sinara-hw/Thermostat_EEM/README.md

# Thermostat_EEM
Thermostat with 4 TEC and 8 sensor channels in EEM form factor

## Design Files

Design files (schematics, PCB layouts, BOMs) can be found at [Thermostat_EEM/Releases](https://github.com/sinara-hw/Thermostat_EEM/releases).

## Wiki

More information can be found on the [wiki](https://github.com/sinara-hw/Thermostat_EEM/wiki).
