sinara-hw/Thermostat_EEM/(threads)

Thread 1 (2020-10-12):

module specification

gkasprow, 2020-10-12:
@jordens
- Do we need PoE?
- I assume that we can connect all AFEs to the same SPI interface, 4 chips per SPI
- DACs will share same SPI interfaces - two chips per SPI
- do we need individual PWMs for each TEC channel?
- I assume we want a downstream/upsteream EEM channel like in the Stabilizer. Was it tested already?
- what connectors? We can use ribbons with DSUB placed on separate panels as in the original Thermostat. But this takes a lot of space. We can also use HD DSUB and have 2 TECs and 4 sensors in each HDSUB15. In this way, noone will mix them with Thermostat or RS232 :) These days nobody is using VGA.

jordens, 2020-10-12:
> * Do we need PoE?

Not strictly need it if causes problems. But it fits the power envelope and would play nicely with the rest of the hardware.

> * I assume that we can connect all AFEs to the same SPI interface, 4 chips per SPI

Yes.

> * DACs will share same SPI interfaces - two chips per SPI

Yes.

> * do we need individual PWMs for each TEC channel?

You mean one MAX1968 per TEC? Yes.
Or do you mean the I/V limit PWMs? Those can be banked, let's say two TECs per set of voltages. But let's try to keep them as separate as possible.
But I might be misunderstanding you.

> * I assume we want a downstream/upsteream EEM channel like in the Stabilizer. Was it tested already?

With Stabilizer not that I know of. With Humpback and Urukul yes.
If there are space/pin problems, I'd rather drop the EEM connector but keep PoE.

> * what connectors? We can use ribbons with DSUB placed on separate panels as in the original Thermostat. But this takes a lot of space. We can also use HD DSUB and have 2 TECs and 4 sensors in each HDSUB15. In this way, noone will mix them with Thermostat or RS232 :) These days nobody is using VGA.

I'm only waiting for someone to connect a monitor to a Booster main board ;)

Do you mean [DE-15](https://en.wikipedia.org/wiki/D-subminiature)? Fine with me.
@j-hirsch and FBH should weigh in.

gkasprow, 2020-10-13:
The pinout could be as follows
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

gkasprow, 2020-10-21:
It looks like we will have individual PWM channels for all TEC driver settings.

gkasprow, 2020-10-28:
Initial placement
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

jordens, 2020-10-28:
When running one big tec from two channels in parallel, would we connect them on the header board?

gkasprow, 2020-10-28:
I'm not 100% sure if you can easily run two channels in parallel. These are synchronous converters - even a small differences in duty cycle will result in high cross-current flowing within the pair of shorted outputs. The header board is for debugging purposes.

jordens, 2020-10-29:
Aren't the drivers effectively current sources which should work in parallel? FBH indicated that they need one case with two in parallel. Best to disuss with @j-hirsch @schiemangk.

jordens, 2020-10-29:
Alternatively it might be easy to just use two electrically separate half-size TECs to get the same result.

hartytp, 2020-10-29:
looks nice! Any further thoughts about power management here? Can you get enough juice out of a single EEM for that many TEC drivers?

jordens, 2020-10-29:
It'll need active power management and load sharing anyway. EEM is probably not going to be the use case for us but the connector/cable is probably not going to be the limitation. It's just there because we can.

Closed 2020-11-03.

Thread 3 (2020-10-28):

CPU signal assignment

gkasprow, 2020-10-28:
@jordens Please have a look at the CPU signal assignments.
It should be coherent with the STM32MX project
[Thermostat_8CH.zip](https://github.com/sinara-hw/Thermostat_EEM/files/5454705/Thermostat_8CH.zip)

jordens, 2020-10-29:
Looks good!

* What do you think about PWM for the fan?
* Can we add some minimal mounting studs or other arrangement for the fan?
* (Note to self: use AIN[0-3] vs AIN4 for NTC symmetry measurement, leakage/bad connection, thermocouple voltage check.)
* Is there something useful we can do with the ADC GPIO? Maybe enable/disable Vref+ (at R36, which I'd really like if possible)? Or at least a SMT LED?
* Agree to go for the 2 channel ADCs for compat and higher sample rate (I think).
* You are not worried that P3V3DVDD might make P3V3AVDD dirty. You change the power supply topology there I think.
* Can we use the remaining two pins on J2 for I2C? Preferrably a separate bus but if that doesn't work with BSS138 isolation.
* One EEPROM with EUI-48 is enough. IC12 can (DNP) go onto the header board (behind the J2 I2C: I2C2).
* What's the bit-bang SPI note for?

I'll go through the CPU assignments later.

jordens, 2020-10-29:
@gkasprow Could you elaborate a bit on the ideal diode design? All I know is [this](https://www.microfarad.de/blog/the-ideal-diode/). Doesn't the body diode always power downstream EEMs and also lead to POE_PWR_SRC being at best one body diode drop below 12V?

jordens, 2020-10-29:
Could we also add support for the unipolar MAX1969? Would only be a beefy jumper from LX2 to LX1 I think (and DNP L4, short C66 C67).

gkasprow, 2020-10-29:
the MOSFET is off by default. When forward currents starts passing via FET diode, the  from EEM to 12V rail, the T10A gets disable and MOSFET is on. Even cunducting FET has enough voltage drop to keep the T10 in off state.

jordens, 2020-10-29:
Ah. I just didn't look close enough. The body diode is reverse biased in the situation I was thinking of.

jordens, 2020-10-29:
@gkasprow I added a couple items to my list above. Really good.

jordens, 2020-10-29:
And finally one idea: can we add headers to support bridge/kelvin measurements on the ADC channels? Just a 16 way DNP IDC header (4 pins per channel with vexc+, sense+, sense-, vexc-) and two 0R jumpers added between vexc+ vsense+ and vexc-/vsense-.

jordens, 2020-10-29:
@gkasprow I added and clarified a couple of the points above.

gkasprow, 2020-10-31:
Let's add 8pin IDC connectors, it's easier to fanout them to DSUB using IDC connectors

gkasprow, 2020-10-31:
I moved the PWM_maxINeg1 to PB5 to free the PC7 which is now TIM8_OC2 and steers the fan PWM

gkasprow, 2020-10-31:
I don't want to make the excitation switchable using MOS switches. What I can accept is a miniature relay. Shall I go for it or 0R resistors are fine? You can always place jumpers on neighboring pins of the IDC8 connectors to enable 2-wire mode without a need for soldering 0R resistors.

gkasprow, 2020-10-31:
I rearranged the placement:
- the PoE module is oriented vertically to make conduction cooling easier. It does not obstruct the air flow,
- all drivers and inductors are arranged vertically so a single heatsink will be able to cover them
- DC/DC is assembled in-line with drivers so can be cooled with a single heatsink/fan
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

gkasprow, 2020-10-31:
@jordens do you want to run all channels with full power? 30W PoE would not be sufficient. We would also need a stronger DC/DC converter.

jordens, 2020-11-01:
ACK the timer move, the IDC connectors, and the arrangements

We'll do active power limiting for both temperature and total supply load. It would be nice to get a current shunt and CPU ADC channel on the 5V or 12V rail in addition to the per-channel power measurements that we already have.
If you already have nice 5V DC-DC blocks that can do a bit more current in mind, that would be interesting when using the Molex/barrel. But more PoE power is a bit awkward infrastructure-wise.

If you don't like to support alternating excitation with switches then let's leave it. Testpoints for GPIO01 instead please.

For the measurement configurations I'd like to ensure the following (I hope the notation is ok):

* Topology on the board should be: Vexc+ Re Vref+ Rr+ Vsense+, and then Vref+ Rs Vsense- Rr- Vref- Re Vexc-
* Rr+-, Rs are same size SMT reference resistors (like the current 5k). Re can be regular size (but having the same size as the 5k ref would be nice) and there only needs to be one set per ADC.
* Vexc+, Vref+, Vsense0+, Vsense0-, Vsense1+, Vsense1-, Vref-, Vexc- are on the IDC connectors.
* Vsense+, Vsense-, and the four Vref- (instead of the GND) are on the D-44 connector.
* For NTC/ratiometric (default): Re = 0, Rr+- = 5k, Rs = DNP, NTC between Vsense+-
* For 4/6 wire/kelvin/bridge: Re = custom/DNP, Rr+- = Rs = DNP, bridge betweeen Vref+- and Vsense+-
* For single-ended measurements with 4 NTCs per ADC (still fully ratiometric), Re = 0, Rr- = DNP, Rs = Rr+ = 11k, NTC_A between Vref- and Vsense+, NTC_B between Vref- and Vsense-.
* Make sure Vref+/- and ADC REF+/- are tied together well, and then tied to the low-passed AVDD/AVSS.
* Make sure AIN4 is tied to Vref-.

Forget about the I2C on the D-44 connector. I don't think that's worth it. Let's do identification and management on the current controler.

gkasprow, 2020-11-01:
@jordens The scenario could be simplified using one DPDT relay. Reed relays are recommended because they don't require minimum operating current as regular relays do. Can you make a paper drawing of the idea? I got lost with these Rr+-
What do you mean by the topology on the board? PLacement of test points?
We don't have any free CPU pins, but I can add I2C current shunt.
stronger DC/DC is not a problem, I can also use two existing ones in parallel.

jordens, 2020-11-01:
Alternatively if you think it may be a good idea to I2C on the header board, then we could reduce the number of wires per TEC to 2. People seem to be talking about 5 A per contact and some 20 mOhm or thereabouts.

gkasprow, 2020-11-01:
What we can do is to reduce the number of TEC wires to two. We will spare 8 pins. Maybe, with SPDT relays we could scrap the internal IDC connectors ?

jordens, 2020-11-01:
Poor man's sketch of the four different use cases I have in mind and the IDC/D-44 and ADC connectivity.

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

Hope that's clearer.

I'd prefer to have at least the four Vref- on the D-44 connector. That would support 16 NTCs with still really good measurement quality.

jordens, 2020-11-01:
To support that kind of chopper mode, we'd need a DPDT relay per ADC to commutate Vexc+- between Vss/Vdd. The relay would be driven from GPIO0 by the ADC sequencer automatically (MUX_IO). It would work with all four use cases. The configurable ADC delay for that looks perfect.

jordens, 2020-11-01:
If we can put all four Vref+ and the four Vref- onto the D-44 connector (by scrapping the third TEC wire) then we can scrap the IDC connectors. Vexc+- and 6 wire mode isn't that interesting to me.
On the D-44 we'd have then 4*2 TEC+, 4*2 TEC-, 8 Vsense+, 8 Vsense-, 4 Vref+, 4 Vref-, SCL, SDA, 3V3_MP, GND. Exactly 44 contacts.

jordens, 2020-11-01:
A 3 m 22 AWG wire has 150 mOhm resistance. That with forward and return and two contacts, that drops 0.45 V at 3 A. Which is a bit annoying. 3 contacts would drop 0.3 V.
Then again, if drop becomes critical, we can just pigtail fatter cables from the D-44. The D-44 still looks like the best connector for the panel. The rest is a question of cabline.

gkasprow, 2020-11-01:
One can also use P3V3 and GND as vexc+-, probably using 3V LDO.

gkasprow, 2020-11-01:
I will use MIC45212 which can give off 14A of current.

gkasprow, 2020-11-01:
@jordens If we route also the GND and VDD, which is the case with I2C, then all possible variants could be possible.
Since we don't need live reconfiguration, I would simply add DIP switches that configure the resistor network. 6 position DIP switch would do the job. Alternate actuation is also ok, we need only DPDT reed relay (20$). Reed relays also introduce very low thermoelectric potential.

gkasprow, 2020-11-01:
Such schematic should do the job.
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

gkasprow, 2020-11-01:
I'm not sure if we can use alternate excitation due to limitation of REF inputs
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
REF inputs can be buffered so we can use identical protection/filtering as in the case of analog inputs.

gkasprow, 2020-11-01:
This is the proposed protection of VREF inputs
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

jordens, 2020-11-02:
The REF+- wiring, MIC45212 look good.
I don't like the DIP switches for the resistor network configurations. I'd rather just have this done in rework.
With the Vexc commutation voltage offsets (due to thermoelectrics or MOSFET resistances) would not be a problem. They are cancelled by the measurement methods. But if -- as you say -- `REF+ >= 1 V + REF-` (I'm somewhat unsure whether this is required) then we can't do it this way. Let's leave it without Vexc commutation and just put test points onto GPIO0/1. I don't like the idea of placing the commutation between Vref and Vsense instead.
Also what's the lifetime cycles of those reed relays? We'd be switching them at 20-50 Hz. That's 1e6/day.

gkasprow, 2020-11-02:
1e6 is too much. They have 1e7..1e8 without load
Do you afraid of the DIP switch's performance? They are not hermetic and after some time the contacts will degrade. We can of course substitute them with reed relays but that would be costly. Another option is [OPTO-MOS](https://datasheet.octopart.com/AQY212EHAX-Panasonic-EW-datasheet-13536469.pdf) relays that have a few tens of Ohm ON resistance, 1e-12 off current, and no leakage to GND at all.

jordens, 2020-11-02:
My thought was to commutate Vexc between successive samples to zero out thermoelectric voltages etc. That can be implemented with the ADC sequencer at maybe 25 Hz. Vexc+ does not need to be very stable, not even between the two polarities, it already has 66 Ohm impedance in Thermostat-v2.0. Only REF+- need to track Vref+- accurately. But if we believe that REF+ > REF- then we can forget about it. Note that the manual also says "The device functions with a reference magnitude from 1 V to AVDD1" suggestiing that the magnitude of the differential counts. But then it says "REF− can span from AVSS to AVDD1 − 1 V" and "REF+ can span from AVSS + 1 V to AVDD1" which mostly exclude it. Let's consider actively commuting Vexc dead.
I don't like the DIP switches to implement the different resistor options in the signal path (or for commutating) because they are physically large, thus take up space and can have significant temperature gradients with thermoelectric potentials. And most importantly I'd expect that  they won't remove the need to change resistors for some applications and the sensor end of the cable will need reconfiguration and soldering anyway. If the single-ended ratiometric option and the bridge measurements prove useful and work well, then I'd be happy to reconsider the DIP switches. What do you think?

Also, if you go for a separate LDO for Vexc+, can we up the voltage (AVDD1 = Vexc+, and maybe also AVDD2) a bit towards the 5 V the ADC can handle? I'd expect dynamic range to increase a bit. I think we can share one LDO among all ADCs.

gkasprow, 2020-11-02:
that's not that bad with DIP switches area.
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
The idea was to just label them 1,2,3,4 where every number means one of the sensor scenarios. So the user simply toggles certain combinations of switches and gets desired input configuration.
I already implemented dedicated LDOs for analog and digital ADC rails.
5V AVDD is OK, the same for Vexc. The ADC can work with neraly any combination of IOVDD and AVDD
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
What if we toggle excitation of the input signals instead of REF?

jordens, 2020-11-02:
I still don't see us making much use of the DIP switches. If I needed DIP-switchable configurations and could live with them in the signal paths, I'd put them on the header board on other side of the cable.

Commutating Vsense+- doesn't help with thermoelectric voltages (you need to commutate the drive as well) and the ADC can already mux the inputs in any configuration. We'd need to commutate Vref+- while leaving the REF+- polarity fixed. That's tricky since that commutation would sit in the signal path where it easily introduces non-symmetric offsets.

jordens, 2020-11-02:
Do you think it makes sense to use two AD7172-4 instead of four AD7172-2? Price per chip is the same, programming and software is compatible. The only downside I see is the lack of the temperature sensor and internal reference (which we don't use).

jordens, 2020-11-02:
Could you explain the reset circuit with the diode between the SWD/JTAG NRST and the CPUT NRST/IC13 reset generator? The reset generator is push-pull but this way the JTAG/SWD can't reset the CPU (only monitor the reset?) and the connection seems useless then.

gkasprow, 2020-11-02:
True, I was already writing that since we have 3V3 and GND, we can realize all scenarios on the header board. So no resistors are needed. I would simply put only default configuration, rest of them can be build using dedicated header boards.
In case of ADC the price is not a big contribution, it's better to use components already used in other designs.

gkasprow, 2020-11-02:
the reset chip is push-pull, it keeps the RSTn pin low for a certain time after power on. Then its output is high and the debugger can pull RST low. The net name should be called RSTn, not RST
The JTAG JRST is not connected now.

jordens, 2020-11-02:
Ah. I mixed up where µC NRST is connected (RST and not CPU_RESETn).

You are right about the resistors not being needed at all here. They could and maybe should all be on the header board! But then we definitely need Vexc- (i.e. GND) and Vexc+ (P5V0A from the LDO, not 3V3) on the D44 connector.

* 4x2 TEC+, 4x2 TEC-
* 8 Vsense+, 8 Vsense-, very high impedance
* 1 Vref+, 1 Vref-, shared among the 4 ADCs, very high impedance
* 1 Vexc+ = 5V0A, 1 Vexc- (GND), low impedance
* SDA/SCL/GND/3V3_MP
* Use the remaining 4 contacts to beef up two TEC drives.

I'm still unsure whether it's better to have I2C on the header board or instead use those four contacts to beef up all TEC connections to three contacts.

jordens, 2020-11-02:
And it's not the best idea to connect AIN4 to REF- since REF- is available as a dedicated mux input already. If you don't have another idea, I think it's best to connect AIN4 to REFOUT (2.5 V reference that we don't use, which is not available as a mux input which gives us a nice (indirect) handle on measuring all relevant frontend voltages single-ended and absolute (measure REFOUT/REF- against REF+/REF-, then measure AIN0-3/REF- against REF+/REF-.

gkasprow, 2020-11-02:
why not use 3V3 LDO on the header board and supply I2C from Vexc+? I2C won't be used often. In this way we would keep all 4 vref pairs

jordens, 2020-11-02:
Yes. Sounds good.

gkasprow, 2020-11-02:
So, to conclude, I will keep only the default symmetrical ratiometric connection.
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

jordens, 2020-11-02:
Yes. Exactly like that. Connect Vref- to REF- and Vref+ to REF+. Bring VREF_5V0 and GND to the connector. No need for the net-ties NT6 and NT2 anymore.

gkasprow, 2020-11-02:
Right, the net ties were needed to avoid the wrong GND routing

jordens, 2020-11-02:
I'd like to change the TEC_U_Meas circuit to be referenced to the MAX Vref 1.5V (not (CPU ADC_REF + REF_GND)/2). That makes these MAX voltages all consistently referenced.
Could you also remove the DAC_FB circuitry? I don't want to use it and instead find the overall offset with ITEC or TEC_U_Meas vs the MAX Vref 1.5V. At least DNP R69 by default and feel free to use those CPU ADC inputs for something else (sensing the 12V current shunt for example).

jordens, 2020-11-02:
I'd also like to be able to measure the P3V3 voltage because the PWMs are proportional to it. The best way I see is to connect VBAT to a scaled P3V3 and then measure VBAT relative to VREFINT (~1.2V) or P5V0A/CPU_ADC_REF.

gkasprow, 2020-11-02:
Right, we have ITEC and TEC_U so these are suffienct means to verify that DAC works. We have free ADC inputs, so we can measure 3V3 directly.

gkasprow, 2020-11-02:
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

gkasprow, 2020-11-02:
the 3V CPU reference generation uses 1% resistors and opamp buffer with offset of 7mV max . Do we need better precision?

gkasprow, 2020-11-02:
I mean this circuit
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

jordens, 2020-11-02:
No. 1% is fine. for me.

gkasprow, 2020-11-02:
I added a new schematic release. Please check it.

jordens, 2020-11-03:
Thanks. I filed individual issues and I think we can close this one.

Closed 2020-11-03.

Thread 11 (2020-11-03):

MAX1969 option

jordens, 2020-11-03:
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

We should move the jumper behind the inductors L2 and L4 to utilize them in parallel and C67/C66 as well.

This should be:

* a jumper between the right sides of L4 and L2 (DNP for bipolar)
* a jumper between the right side of L4 and OS2 (DNP for unipolar)
* (done) a jumper from OS2 to GND (DNP for bipolar).

Can we easily make all three jumpers and the CMC capable of 6 A? If not, 5A is also fine.

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

gkasprow, 2020-11-04:
I replaced the CMC with a[ 1.8uH 9A](https://pl.mouser.com/datasheet/2/336/P850-1527002.pdf) one. Slightly bigger but fits nicely.

gkasprow, 2020-11-04:
I used dedicated 1206 0.5mR jumpers. Standard 0R 1206 resistors are roughly 50mOhm

gkasprow, 2020-11-04:
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

Closed 2020-11-04.

Thread 13 (2020-11-03):

D-44 pinout

jordens, 2020-11-03:
Feel free to shuffle this for most convenient routing on Thermostat and on the header board. I don't care about the pin ordering.

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

gkasprow, 2020-11-03:
I already changed the layout twice to make routing of high current lines easier I will Y-mirror it.

Closed 2020-11-03.

Thread 14 (2020-11-03):

testpoints for MaxCurrentNet/Pos/Voltage

jordens, 2020-11-03:
Could you move those testpoints behind the reconstruction filter?

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

gkasprow, 2020-11-03:
Are U sure?
In the case of DMM, it does not matter, but currently, you can also observe the PWM pattern.

jordens, 2020-11-04:
Ack

Closed 2020-11-04.

Thread 15 (2020-11-03):

Power budget, various notes

jordens, 2020-11-03:
When done, update the power budget. Also remove that note from the top sheet (or from the TH8_Supply.schdoc). It's duplicate.

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

Add a Testpoint and a note to ADC_CLKIO saying: "2 MHz"

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

Closed 2020-11-05.

Thread 16 (2020-11-03):

Supply connectors for sensors.

jordens, 2020-11-03:
If we supply the connectors for the TECs, we should also supply the ones for the sensors.

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

gkasprow, 2020-11-03:
thanks for reminding me. I planned to do so but I forgot :)

gkasprow, 2020-11-04:
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

Closed 2020-11-04.

Thread 17 (2020-11-03):

Fan CPU protection

jordens, 2020-11-03:
Can we increase R9? ~10 mA still sound like a lot going into the CPU pin. And the fan not working might be noticed pretty late.
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

gkasprow, 2020-11-03:
right. it's probably too low to cause latch-up, but for this frequency, 10k would work as well

Closed 2020-11-03.

Thread 18 (2020-11-03):

Allow EEM/Molex/Barrel 12V to be measured with the shunt

jordens, 2020-11-03:
These should drive P12V0_R

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

jordens, 2020-11-03:
And the EEM (by default) as well.

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

gkasprow, 2020-11-03:
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

The only issue is that the load connected to EEM is not measured.
What we can do is to add yet another FET that would redirect the current when powering downstream port
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

jordens, 2020-11-04:
I don't think that's necessary. But I'll leave it to you.

gkasprow, 2020-11-04:
let's keep it simple then.

Closed 2020-11-04.

Thread 19 (2020-11-03):

I2C isolation

jordens, 2020-11-03:
Let's use CPU_RESETn to drive those FETs. It's later than P5V0 and later than P3V3

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

jordens, 2020-11-03:
I'd also place the LM75 on the EEM side of the I2C bus (I2C_SDA/SCL instead of I2C4_SDA/SCL)

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

jordens, 2020-11-03:
And we need 10k pullups to P3V3_MP on the EEM side of the I2C bus (I2C_SDA/SCL).

gkasprow, 2020-11-03:
I'd use P5V0A which wakes up as the last one after P3V3. It will result with lower Rdson.

gkasprow, 2020-11-03:
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

Closed 2020-11-03.

Thread 21 (2020-11-03):

board guide keepout

jordens, 2020-11-03:
We should not put top layer traces into the board guide area. That'll work against metallic enclosure edges and wear of the solder mask. It's also no good for cPCIs IIRC.

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

gkasprow, 2020-11-03:
that's not top layer. The trace is on L2. It may look misleading due to prepreg transparency settings:)

jordens, 2020-11-03:
Ah. Ok then!

Closed 2020-11-03.

Thread 22 (2020-11-03):

PoE again

jordens, 2020-11-03:
A few thoughts:

Looking at the [SMSC app note on PoE](http://ww1.microchip.com/downloads/en/AppNotes/en562768.pdf), they recommend a different circuit for protection: back-to-back 3.3V TVS/Zeners accross RD and TD. Apparently lots of capacitance allowed here (50 pF differential).

Second, I'm a bit worried about the mismatch between the [ESD diode datasheet](https://www.onsemi.com/pub/Collateral/NUP4114-D.PDF) and the schematic symbol:

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

Unlike the symbol, in the datasheet there is no explicit protection of the data lines to AVDDT_PHY at all. It's only a Zener + forward diode to GND. And that Zener has 8.3 V clamping voltage (1 A) and 6.5 V breakdown (1 mA): higher than the abs max of the [PHY](http://ww1.microchip.com/downloads/en/DeviceDoc/8742a.pdf) (3.3 V + 2 V = 5.3 V), higher than expected from the schematic symbol if it was only a forward diode drop to 3.3V (AVDDT_PHY), and higher than the 3.5 V "punch-through" + forward diode drop or 4.5 V clamping (1A) plus forward diode of the [SMSC design](http://www.farnell.com/datasheets/1749617.pdf).

Third, I think in our design the AVDDT_PHY protection of 8.5 V is still a bit loose compared to the 3.6 V abs max of the PHY. Yes, there is plenty of capacitance to dampen the surge, but still. Needs to be compared to the ~20V*1µs transients that the SMSC App note shows.

TI [talks](https://www.ti.com/lit/ug/tidues1a/tidues1a.pdf) about [ESDS312](https://www.ti.com/lit/ds/symlink/esds314.pdf) and [LC0-3.3](https://www.littelfuse.com/~/media/electronics/datasheets/tvs_diode_arrays/littelfuse_tvs_diode_array_lc03_3_3_datasheet.pdf.pdf) 3.3V clamps/ESD/surge/lightning protection.

Also re https://github.com/sinara-hw/Thermostat/issues/83

This also applies to the other instances where we use that ESD diode pack (USB, 3x I2C, JTAG) and Stabilizer and Thermostat (non-EEM) as well.

gkasprow, 2020-11-03:
True, the symbol is wrong!
This could explain why PHY died.
Good catch!
We also need to replace it with the Stabilizer module.
Fortunately, I did not update all other designs with this part!
What we need is not necessarily Zener diode but fast protection diodes where excessive charge can be dumped to the supply rail. This would work
https://datasheet.octopart.com/PRTR5V0U4Y%2C125-Nexperia-datasheet-87582156.pdf

gkasprow, 2020-11-04:
I'm not sure if the cathodes can be connected to 3V3 rail. It will limit the max voltage produced by the PHY chip (there is a transformer with center tap). Maybe we should connect it to 5V rail instead...

gkasprow, 2020-11-04:
the maximum ratings say:
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

gkasprow, 2020-11-04:
on the other hand, the TX won't exceed 1V
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

gkasprow, 2020-11-04:
which means that we have AVDDPHY + 0.5V on one output and AVDDPHY -0.5V on complementary output. The TVS diodes should not clip such amplitude

jordens, 2020-11-04:
I always thought they were complementary and just switch between 0 and avddphy. I would not expect them to get above avddphy actively. There will always be one inactive half of the winding. Induced voltages in the inactive half should be clamped to avddphy+diode in the phy. No?

gkasprow, 2020-11-04:
These are analog signals. 3-state sequence. The transformer central tap is connected to 3V3, so when one output pulls low, the other gets the same value above the bias. The PHY does not have the clamping diode (it accepts up to 5.3V), it's like an open-drain circuit. That's why it can be vulnerable to damage.

jordens, 2021-05-04:
Note for the next time we revisit this: We could also try "more robust", "industrial" PHYs like the DP83822.

gkasprow, 2021-05-04:
Good ida. But I would do it in case we observe chip failures.

Closed 2020-11-04.

Thread 4 (2020-11-03):

P5V0A as Vexc on the header board

jordens, 2020-11-03:
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

Not P3V3_AFE.

Also maybe add (a ferrite bead and) 100 n decap to P5V0A on the header board.

jordens, 2020-11-03:
And I think we may want to add a polyfuse on Thermostat towards the D44 connector P5V0A.

gkasprow, 2020-11-03:
This comes from 300mA LDO. I'm not sure if it's worth adding PTC to BOM

jordens, 2020-11-03:
Right. I guess the LDO will just shut down.

gkasprow, 2020-11-03:
yes, it will get thermal shutdown.

gkasprow, 2020-11-03:
on the header board, we have 33Ohm series resistor already

jordens, 2020-11-04:
That's for the P3V3_AFE LDO, right? For the excitation voltage to the sensor connectors I'd like P5V0A with no large added resistance, just some filtering. (e.g. load cells are just a couple hundred Ohm only and like to pull > 10 mA at 5 V.)

Closed 2020-11-03.

Thread 7 (2020-11-03):

P5V0REF

jordens, 2020-11-03:
Do we need P5V0REF?

* The DACs don't need to be extremely accurate. They are in-loop and relative to the somewhat unstable MAX Vref.
* The CPU ADC reference is as inaccurate as the resistors/buffer.
* The P5V0A seems clean and has enough power

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

jordens, 2020-11-03:
Maybe it's much better to have a 3V reference for the DACs and the CPU ADC. Then there would be no need for the IC10 buffer, the R54/R70 divider and the R88/R87 divider. Drive IC5 VDD from P5V0A with a bit of resistance to isolate it.

gkasprow, 2020-11-04:
Good idea. I don't remember what was the rationale behind supplying the DAC REF from 5V. The DAC performance is not critical here.

Closed 2020-11-04.

Thread 8 (2020-11-03):

P3V3IO

jordens, 2020-11-03:
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

Can't find it being used anywhere.

jordens, 2020-11-03:
I see that you use it for the ADC IOVDD. My PDF viewer didn't find it in a search.

You know best whether having a separate supply is necessary there. Fine with me.

Closed 2020-11-03.

Thread 9 (2020-11-03):

Check fan PWM

jordens, 2020-11-03:
On Phaser I couldn't get the fan to turn off.

https://github.com/sinara-hw/Phaser/issues/107

jordens, 2020-11-03:
Looks like you used BSS138 with the higher Vth. So let's try it and maybe short C82 in later revisions if it doesn't work.

Closed 2020-11-03.

Thread 23 (2020-11-07):

D44 assembly

jordens, 2020-11-07:
With the connectors like this, the two boards have to be separated before soldering the D44 connectors. Breaking on the drill line after soldering probably won't work because you can't bend the connectors when connected. Is this the intention?

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

gkasprow, 2020-11-07:
breaking will be easy
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

The connectors will be mounted after all, but U are right, they can be also mounted automatically - we have such machine. I will separate them a bit.

jordens, 2020-11-07:
Yes. I have seen the break line. But that breaks by bending and you can't bend the connectors when mated. So you'd have to make sure that they are mounted after breaking. I don't know how the assembly works and how much is done manually, but it might be easier to allow the board to be broken off after all assembly. That would require separating the boards by more.

gkasprow, 2020-11-07:
Actually we have a special machine that separates the boards. We don't break them manually.
It's logistically easier to do after automatic soldering. Once you separate them, It's hard to grip it for automatic soldering...

jordens, 2020-11-07:
Right. As mentioned I thought that you solder before separating. Then I wonder how the machine separates without bending or shearing (which would both stress the mated connectors a lot) and also without direct access to both sides of the drill lines.

jordens, 2020-11-08:
I guess if it's a saw that does the separation, this is fine.

gkasprow, 2021-01-19:
I separated the two boards
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

Closed 2021-01-19.

Thread 24 (2020-11-07):

P5V0_AFE as Vexc on the header board

jordens, 2020-11-07:
Still #4.

* I'd like to have P5V0_AFE to serve as Vexc (pin 8) on the connectors J7,J8,J11,J13, not P3V0_AFE.
* That's why on the header board I'l like more filtering capacitance for P5V0_AFE.
* The P5V0A trace to the D44 connector on the main board should also become a bit thicker (8*10 mA) as should the trace on the header board.

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

gkasprow, 2020-11-07:
Right, 3V3 doesn't make much sense here

gkasprow, 2021-01-19:
I added FB + 100nF, also routed dedicated 20mils trace directly to the LDO

jordens, 2021-01-19:
LDO? That should be P5V0_AFE.
The LDO is only for the EEPROM, right?

gkasprow, 2021-01-19:
Yes, it is only for EEPROM.

Closed 2021-01-19.

Thread 25 (2020-11-07):

CurrentSet needs filtering

jordens, 2020-11-07:
I think there should be RC filtering on the DAC output since it uses 10 kHz PWM to get the two LSBs. Something like 1 kHz seems good.
We can also just use 16 bits and then there won't be PWM tones.

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

gkasprow, 2020-11-07:
OK, it was there originally, I forgot why :)

gkasprow, 2021-01-19:
done
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

Closed 2021-01-19.

Thread 27 (2020-11-07):

AIN4 to GND

jordens, 2020-11-07:
(Reverses https://github.com/sinara-hw/Thermostat_EEM/issues/3#issuecomment-720581202)

* AIN4 should be connected to GND to measure single ended voltages easily.

I misread the AD7172 datasheet and didn't see the option to use the internal reference independent of what's connected to REF+-. Sorry about the confusion.

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

gkasprow, 2021-01-19:
done
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

Closed 2021-01-19.

Thread 28 (2020-11-07):

P5V0A load

jordens, 2020-11-07:
I think the R at the P5V0A LDO input needs to go away. ADCs, DACs and the Vexc branches are about (3 + 1 + 20 mA) * 4 ~ 100 mA max. That would bee too much for that 1/16 W resistor.

* Maybe just R105 = 0R? The ADCs and DACs have their own RC filtering already.

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

gkasprow, 2021-01-19:
we already use 10R 0805 resistors so I will place two in series.

Closed 2021-01-19.

Thread 29 (2020-11-08):

polarity marker for jtag connector

jordens, 2020-11-08:
* Since it isn't keyed, it should at least get a pin-1 marker, https://github.com/sinara-hw/Thermostat/issues/76
* Also make sure that the connect fits, see https://github.com/sinara-hw/Thermostat/issues/75

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

gkasprow, 2020-11-08:
The PN used in the design is EOL.
What about using this one from Samtec, with the key?
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

jordens, 2020-11-09:
The non-keyed connectors would fit that one as well, right?
Then that's good. Still, please add a pin-1 marker if the footprint doesn't have one.

gkasprow, 2020-11-17:
Harwin M50-3600542R fits well existing footprint

gkasprow, 2020-11-17:
Connfly ZL322-2X5P works as well

gkasprow, 2021-01-19:
fiexd. I used  M50-3600542
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

Thread 30 (2020-11-09):

AD717[2567]

jordens, 2020-11-09:
Quick analysis of pin- and software-compatible alternative ADCs.

tl;dr: The AD7175 is an interesting option over the AD7172 for fast loops (faster than 50 Hz data rate).
Let's stick with the ad7172 for now.

* 2,5,6,7 are all pin-compatible and register compatible. This is stressend by the common ADI noOS driver.
* AD7175 is very similar to the 2, (almost) same base rms noise, but higher base sample rate (250 kS/s vs 31 kS/s, factor 8).
* AD7175 has 8 times higher clock/modulator frequency and about 8 times the current consumption.
* AD7176 is the AD7175 without buffers
* AD7177 has 32 bits but the same in-band noise as the AD7175. It's useful if the data rate is under 400 Hz compared to the 5.
* The 5's higher base sample rate (before the filters) at the same base quantization noise directly leads to less voltage noise (about sqrt(8)) at the same output sample rate.
* Once the filtered voltage noise drops below the filtered (24 bit) quantization, the later dominates. That's at 400 Hz and 60 Hz for the 5 and 2 respectively.
* Tempco is dominated by the 5ppm/K reference resistors. There are 2ppm/K resistors available from the same series. Going to <1 ppm/K reference resistors (through hole) and six wire measurement (remote excitation) or a <0.5 ppm/K current source and four wire measurement would start to make the ADC the dominant part. Both alternative setups are possible with the current design.
* The ADCs have 0.2 (AD7172) and 0.4 ppm/K (AD7175) typ. But looking at the actual distribution of those drifts they are indistinguishable to me. Unclear what the measurement accuracy is and the device drift might even be indistinguishable from zero.
* 10k||(5k+5k) Johnson noise in 500 Hz is 0.2 µV. 24 bit quantization is 0.17 µV rms. The two reference resistors additionally contribute 0.06 µV/V current noise (in one decade bandwidth, 1/f) each. We run them at 1.25 V.
* NTCs also have current noise. Maybe even 1 µV/V (20 µK/V) in 0.01-1 Hz depending on the design ([Ryger et al. Rev. Sci. Instrum. 88, 024707 (2017)](https://pdfs.semanticscholar.org/1198/54a2bf7d9f0db15f1273141bfb6e8449f83b.pdf). We run at 2.5 V.
* 50 Hz should be the sweet spot for the AD7172 (ENOB 24 bit and 50 Hz notch with minimal latency), 400 Hz for the AD7175
* The current design has a 160 Hz RC filter (200n, 10k||(5k+5k)) before the ADC limiting the bandwidth and latency
* Thermal gradients between effective temperature of interest and sensor are typically larger than 1 mK (50 µV, 1 µHz-0.1 Hz, after settling, with a decently designed multi-layer actively shielded commercial optical ULE cavity).
* For faster loops with closely coupled TECs, thermal mass, and sensors, or other types of sensors and measurements, the lower noise of the AD7175 is superior.

Current Thermostat noise is 0.5 µV [2.5 LSB](https://github.com/sinara-hw/Thermostat/issues/46) at 3.3 V ref and 27 S/s (0.45
 µV datasheet).

gkasprow, 2020-11-09:
For me is fine, it would be good to use it in both Thermostat designs.

jordens, 2020-11-09:
Agreed. These were just my notes what would need to be done to get to faster and even more accurate/stable/low-noise control loops.

Closed 2020-11-09.

Thread 31 (2020-11-09):

input filter capacitors

jordens, 2020-11-09:
Let's lower C105, C46, C110, C53, C120, C121 from 100 nF to 10 nF to get a 1kHz corner (10+(10||10) nF and 10||(5+5) k). This is still 120 dB at the first alias. Matches the 1 kHz corner filter after the DAC (https://github.com/sinara-hw/Thermostat_EEM/issues/25).

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

gkasprow, 2021-01-19:
Do the same in Thermostat as well?

gkasprow, 2021-01-19:
done

filipswit, 2021-11-22:
Modified:
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

Closed 2021-11-25.

Thread 34 (2020-11-10):

J7,8,11,13 Vrefbx- close to GND

jordens, 2020-11-10:
Please move Vrefbx- to pin2 close to the GND pin1 on J7/J8/J11/J13.

The pinout from pins 1-8 should be GND, Vrefbx-, SENSBx_2, SENSBx_1, SENSBx_2, SENSBx_1, Vrefbx+, P5V0_AFE.

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

gkasprow, 2021-01-19:
done
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

jordens, 2021-01-19:
Good idea! But then R129 and R130 should be treated the same. They should also move to the header board. and be placed accross pins 8-7 and 1-2 respectively.

And I'm not sure we need this section then anymore:
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

gkasprow, 2021-01-19:
right!

gkasprow, 2021-01-19:
done
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

Closed 2021-01-19.

Thread 35 (2020-11-10):

0805 footprints for reference resistors and wider sense traces

jordens, 2020-11-10:
Currently the reference resistors dominate the temperature coefficient (an order of magnitude more than ADC gain tempco, lead resistance tempco, lead thermoelectric emf, ADC offset tempco, resistor voltage coefficients).
A fix would be to get better resistors.

Those could in principle be on the (actual) header board. That would also cancel lead resistance tempco and lead resistance offsets/instabilities. Alternatively we could go to 0.2 ppm/C resistors. 5k is available in 0603 (Y16365K00000F0W). But many more resistors are available in 0805 size from 0.2 ppm/C (Y16295K00000T9R) to the existing 5 ppm/C.

* Could we go for 0805 size reference resistors (e.g. TNPU08054K99BZEN00 or better Y16295K00000T9R for R91 R44 R132 R50)? Resistance can be anywhere from 4.7-5.2k.

To stay below the effect of the reference resistor tempco (in the default 2 wire measurement configuration), the traces between the reference resistors and the NTC need to stay below 0.3 Ohm. That's 10 cm of 6x1.38 mil trace max (round trip).

* Could we widen the sense traces (SENS[01]_[PN] net from the reference resistors R91 R44 R132 R50 to the D44 connector and on the breakout board) to 10 mil?

gkasprow, 2020-11-10:
Sure, let's go.
The most precise ones are in the miniMELF package (1206). We have a lot of space.

jordens, 2020-11-11:
Are you sure? On digikey, the common SMT resistors around ~5k and 0.2 ppm/K are 0805, some 1206, no miniMELF.

gkasprow, 2020-11-11:
It used to be the case 15 years ago. It was easier to seal miniMELF. Bit it seems the situation changed recently :)

gkasprow, 2021-01-19:
Let's go for Y16245K00000T9R. I have them already in my libs.

jordens, 2021-01-19:
Agreed

gkasprow, 2021-01-19:
I added them on the header board, the ones close to DACs will be DNP
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

Closed 2021-01-19.

Thread 36 (2021-01-19):

cooling

gkasprow, 2021-01-19:
I added optional cooling - it consists of the fan (same model as used in Thermostat) and a piece of PCB or metal plate.
The mounting plate distributes the airflow between the channels. The inductors form the air duct so that should work.
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

gkasprow, 2021-01-19:
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

jordens, 2021-01-19:
Maybe that's also a useful approach for (https://github.com/sinara-hw/Phaser/issues/101#issuecomment-682044877)

gkasprow, 2021-01-19:
The mounting holes will fit.

Closed 2021-01-19.

Thread 38 (2021-01-19):

Move R129 and R130 to the header board.

jordens, 2021-01-19:
Good idea in #34! But then R129 and R130 should be treated the same.

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

They should also move to the header board. and be placed accross pins 8-7 and 1-2 respectively.

And I'm not sure we need this section then anymore:
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

_Originally posted by @jordens in https://github.com/sinara-hw/Thermostat_EEM/issues/34#issuecomment-763129398_

gkasprow, 2021-01-19:
I moved them and made that section DNP

jordens, 2021-01-19:
Perfect

Closed 2021-01-19.

Thread 39 (2021-01-20):

support for cryogenic temperature sensors

gkasprow, 2021-01-20:
I want to use Thermostat to sense 4K enviorenment using silicon sensors, for example one of [these](https://www.lakeshore.com/products/categories/overview/temperature-products/cryogenic-temperature-sensors/dt-670-silicon-diodes)
The diode characteristics is below
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
it should be easy - connect the ADC references to external reference voltage, for example 3ppm LM4140 which gives 2.048V
and then use current source based on opamp + LM4140 (1.024V) to generate 10uA current.
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

 Then use 4 wires to connect the sensor.
@jordens do you think that makes sense?

gkasprow, 2021-01-20:
Another option is to use a current sink that would use a common reference source for all channels, then eight opamps + 8 low leakage current JFETs

jordens, 2021-01-20:
The ADC has an internal 2.5 V 2ppm/K reference already. That's usually enough. I'd build a current source on the header board and implement Kelvin sensing.

Beyond that:
If you can make a good star-ground near the diodes and sense that with one of the input channels you'd get more diodes per ADC. You can also put several diodes in series of a CC source.
Maybe you could even use the REF+, REF- terminals as two additional independent inputs if you use the internal reference. The datasheet seems to indicate that they can be used as such. With a good star ground and REF- connected sensing, you could measure four diodes (AIN[0:3] against REF-).
Calibration, uncompensated Thermocouple voltages and lead resistance for non-Kelvin are probably the biggest problems.

gkasprow, 2021-01-20:
Sure, by writing "Then use 4 wires to connect the sensor." I meant Kelvin connection. I was thinking about using two similar references or even one with the hope that their tempco will compensate to some extent :)
2.048V reference will let me use more ADC range but the ADC one has a lower tempco.
I ordered calibrated thermometer so can use it as a reference. I want to implement some interpolation in the Thermostat firmware, connect 8 sensors attached to the same cold head as reference sensors and do the calibration automatically. It won't be that simple at 4K due to several possible issues, but I won't know until I try.

gkasprow, 2021-01-20:
Here is the proposed AFE for cryo sensors. The sensor wires are long, I want true differential inputs. 8 channels are fine.
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

gkasprow, 2021-01-20:
I'm not sure if the ADC will handle 5V common-mode signal..

gkasprow, 2021-01-20:
I can always add 120k resistor in series with P5V0_AFE...

jordens, 2021-01-21:
* With Kelvin I only wanted to say that I think your approach of 4-wire is exactly right.
* Why do you need the JFET and low-side drive of the diode? Can't the opamp drive high side excitation of the diode (if you want, through a resistor to protect the diode a bit)? (8: opamp out through 120k protection, 7+6: sense, 5: 120k burden/shunt to GND). That would also get the sense signals common mode away from the rails.
* I don't think a second reference for the ADC will help.

gkasprow, 2021-05-21:
right! we can scrap the MOSFET this way

Closed 2021-05-21.

Thread 40 (2021-02-03):

P5V0A protection zener

jordens, 2021-02-03:
Let's go for the slightly higher zener protection diode here. 1SMA5920BT3G, 6.2 V instead of 5.6 V.
The ADC has 6.5 V abs max and the CPU side is powered by an independent 3V3 supply.

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

In light of previous experience.

gkasprow, 2021-05-21:
done

Closed 2021-05-21.

Thread 42 (2021-02-15):

High power PoE

gkasprow, 2021-02-15:
There are 60 and 85W PoE [modules](https://silvertel.com/ag5800/) avaialble from Silvertel.
They need an 802.3bt class switch but are backward compatible with AT sources

jordens, 2021-02-15:
Nice. To me AT compatibility is crucial, I don't see BT switches very often.
I'm really looking forward to active temperature, total power management, sharing, and dynamic limiting on Thermostat and especially Thermostat_EEM.

gkasprow, 2021-03-01:
the  802.3bt  module has 17mm, it's too high for 4HP EEM

gkasprow, 2021-03-01:
But, [AG5810](https://silvertel.com/ag5810/) would fit. But would require significant board re-design

jordens, 2021-05-04:
Isn't the fan mezzanine (incl screw heads etc) too high for 4 HP anyway? Even if it just fits, wouldn't the fan choke on the proximity to the adjacent board?

gkasprow, 2021-05-04:
The idea is to use it when a convection cooling or fan tray is not used. In such cases, we could either install a 2HP filler or go for an 8HP panel.

Thread 43 (2021-02-17):

Stm32h7

jordens, 2021-02-17:
Let's consider moving to the stm32h7 right away. Price is almost the same, more power, newer architecture, lots of experience with it on stabilizer now.
I think there is a pin compatible stm32h743 to the f4 that we are using. It might just be a bom.change.

@gkasprow what do you think?

gkasprow, 2021-02-17:
Let's do whatever is easier from SW's point of view.

jordens, 2021-02-18:
Ok. Let's do stm32h743zit6 as on Stabilizer then. The H7 teething problems appear to be over and I can see the need for some additional computation power here.
I think this is a drop-in replacement but it's probably worth verifying the complete pin config.

c.f. old discussion at https://github.com/sinara-hw/Thermostat/issues/12

gkasprow, 2021-03-14:
done, please check the CubeMX project
[Thermostat__EEM_8CH.zip](https://github.com/sinara-hw/Thermostat_EEM/files/6137141/Thermostat__EEM_8CH.zip)

SingularitySurfer, 2021-03-17:
Hi, I looked at the schematic and I couldn't find anything wrong with the pinout. But I also don't know the exact timer/ADC configuration etc. and generally this is the first time I properly looked at Thermostat in depth. So maybe someone else should check as well.

jordens, 2021-03-18:
@gkasprow Is there a chance to group the timer channels a bit clearer? Specifically:

* Can we put PWM_maxINeg1 onto the same timer (TIM8) as the three other? I.e. swap FAN_PWM and PWM_maxINeg1.

gkasprow, 2021-05-21:
they are not mounted by default
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

Closed 2021-05-21.

Thread 45 (2021-10-20):

ADC_DOUT/RDY to SPI_MISO and EXTI

jordens, 2021-10-20:
It's useful to interrupt when the ADC is ready instead of polling. For that it's nice if we can use an EXTI interrupt from a GPIO input pin concurrently with SPI. Then we don't have to reconfigure the single pin between SPI and GPIO all the time and don't run into software issues when doing so.

We should connect ADC_DOUT/RDY to both SPI_MISO (PE5 as currently) and some other pin for EXTI usage (e.g. PC11 currently unused).

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

filipswit, 2021-11-22:
Connected PC11 RDYn to ADC_DOUT/RDyn through 0R jumper:
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

Closed 2021-11-25.

Thread 46 (2021-10-20):

RC filter on CPU ADC channels (ITEC)

jordens, 2021-10-20:
Let's make them all 10k/10n for 1.6 kHz bandwidth.

Add a RC filter with the usual 10k/10n combo on ITEC on all 4 TEC channels.

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

Maybe (?) add a 10k/10n RC on the VREF signal to the CPU ADCs on all 4 TEC channels

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

Increase the RC on the TEC_U_meas signal to 10k/10n on all 4 TEC channels

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

Lower the RC on I_MEAS_12V to 10k/10n

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

filipswit, 2021-11-22:
Added 10k/10n to ITEC and Vref
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

Increased TEC_U_meas to 10k/10n
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

Decreased I_meas_P12V0 to 10k/10n
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

Closed 2021-11-25.

Thread 47 (2021-10-21):

cable on BOM

jordens, 2021-10-21:
I can't find the fan, the fan board, and the mounting hardware (8 screws, washers, 4 spacers) on the schematics. Let's make sure they are included in the BOM for the board.
Also let's try to get the cable into the BOM if there is the test AFE in it.
I see that you have a suitable cable link on the schematic already.

gkasprow, 2021-10-21:
The spacers are SMT-mounted ones (S1..S4), screws are there on the top entity page (SCREW1...4).
Fan board is here
https://github.com/sinara-hw/Thermostat_EEM/tree/master/Fan_board_Thermostat%208CH
the fan and mounting HW is here
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

Closed 2021-11-25.

Thread 48 (2021-11-24):

Stock problems v1.0

filipswit, 2021-11-24:
Due to stock problems:

- Alternate power supply section has been added.
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

- Indicator leds are 4x green instead of 2x green and 2x red
- ARJM11C7-114-BA-EW2 changed to 2337992-8

jordens, 2021-11-24:
That's a 6 A limit now. A bit small compared to the 14 A of the MIC. It would be good if we can at least make 8 A, better 12 A (3 A per TEC not including losses). We have a high power 12 V connection that can supply enough. I'd rather not be limited by the 5 V power supply.

filipswit, 2021-11-24:
It's hard to find something what is small enough, high current and it's possible to buy in this year.

jordens, 2021-11-24:
If this is an emergency alternative, OK. Can we make the boards so that they can be upgraded to the MIC by rework when available?

akaminska, 2021-11-24:
@jordens this is only a temporary solution for the purpose of the prototype series, in order to be able to manufacture it now. If you think that it will be really useful, we can try to squeeze in one more 584-LTM4623EV#PBF

filipswit, 2021-11-24:
@jordens We treat LTM4623 as temporary solution. MIC section is left as it was, we would like to mount all RC components and as soon as MIC will be available, upgrade will be possible.

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

filipswit, 2021-11-25:
@jordens finally i squeezed there 3rd DC/DC so now we have 3x3A.

Closed 2021-11-25.

Thread 49 (2021-12-14):

Fan board issues

filipswit, 2021-12-14:
- [x] screws should be 14mm instead of 12mm
- [x] pcb should be at least 1.4mm thick
- [x] missing fan connector

gkasprow, 2023-02-17:
@filipswit what do you mean by missing fan connector?

gkasprow, 2023-02-17:
what's wrong with 12mm screws?

filipswit, 2023-02-17:
- Fan connector should be added to BoM (Mating to Molex 22-27-2031)
- AFFAIR 12mm screws were barely touching the thread

gkasprow, 2023-03-06:
Screw replaced with KRAFTBERG_M2.5X14/D7985-A2
Added connector 22012031 and KK contacts 08-52-0125
Thickness is standard 1.6mm

Closed 2023-03-06.

Thread 50 (2022-01-13):

v1.0 issues

filipswit, 2022-01-13:
- PDR ON signal on STM32 should be tied to P3V3
- Remove paste layer from the testpoints on one of the DAC/PWM
- Modify cutout under USB connector

gkasprow, 2023-02-17:
@filipswit what's wrong with USB cutout?

filipswit, 2023-02-17:
It is 7.5mm wide, but should be 7.7mm.

Closed 2023-03-06.

Thread 51 (2022-02-03):

Ethernet PHY can only negotiate 10BASE-T link

nkrackow, 2022-02-03:
The lan8742 PHY is not able to negotiate a 100BASE-TX connection with the other side of the Link.

This was tried with 2 different ~1m RJ45 cables (One is Cat.5E) and 3 different USB-Ehernet adapters. With one of the adapters it does not work at all, with the other two the link status glitches between on and off for about 10 sec until the link stabilizes to on with a 10BASE-T connection (which is determined by reading the PHY status regs).
The cables don't make a difference and all adapters and cables work instantly with Stabilizer.

The only difference to Stabilizer in the schematic are these 33 ohm inline resistors:
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

In the layout the traces are much longer.

gkasprow, 2022-02-03:
The thermostat (2 channel version) is using the same resistors. I didn't check what speed it negotiates though.

SingularitySurfer, 2022-02-03:
Just checked, it negotiates 100Mbit and also instantly connects.

The problem is that the drivers we are using only support 100BASE-TX full-duplex..

jordens, 2022-02-03:
@SingularitySurfer quickly check that the ESD array footprint, schematic, and datasheet actually match. There were problems with that before.

gkasprow, 2022-02-03:
which revision of the Thermostat do you have? these resistors were added quite recently.

SingularitySurfer, 2022-02-03:
I've got Thermostat v2.0 and Thermostat-EEM v1.0.

ESD array footprint, schematic, and datasheet are the same for both Thermostats and Stabilizer.

SingularitySurfer, 2022-02-03:
The resistors are not present in Thermostat v2.0 I think.

gkasprow, 2022-02-03:
right. They were added in v2.1

SingularitySurfer, 2022-02-03:
Unfortunately I think I ESD-damaged my PHY while bridging the resistors. I'll try swapping the PHY and bridging the resistors tomorrow.

jordens, 2022-02-03:
@gkasprow where does the 33R series come from, was it a guess to add some more ESD robustness or is that a proven design?
The [phy schematic checklist](https://ww1.microchip.com/downloads/en/DeviceDoc/LAN8742A%20QFN%20Rev%20A%20Schematic%20Checklist.pdf) doesn't have them. But it also doesn't have the ESD diodes so it's of limited value.

gkasprow, 2022-02-03:
It was recommended in PoE app note to prevent PHY from dying

jordens, 2022-02-03:
The one you referenced [here](https://github.com/sinara-hw/Thermostat/issues/83#issuecomment-719920167) talks about 0-5 R.
But for that short cable that @SingularitySurfer I wouldn't expect it to make a difference.

gkasprow, 2022-02-03:
you can short them and see if that makes any difference. So far nobody complained about Thermostat...

SingularitySurfer, 2022-02-04:
Turns out I ESD damaged the ESD protection diode array such that there appeared another diode to from the data lines to ground..

SingularitySurfer, 2022-02-04:
With a new PHY, no ESD protection diode array and shorted resistors I instantly get a 100BASE-TX connection.

gkasprow, 2022-02-04:
the ESD diodes must be there. Otherwise after plugging PoE you will damage PHY instantly,

gkasprow, 2022-02-04:
you can "borrow" the ESD array from the I2C circuit close to EEM connector (D17)

SingularitySurfer, 2022-02-04:
Since I don't use PoE I don't need the diode array right now. Would you like me to check if the diode array in there makes a difference? I don't think that's so likely since it's also there on other devices where it works.

gkasprow, 2022-02-04:
these TVS arrays have very low capacitance and are used in Stabilizer already.
The only thing that changed are these resistors. So I think they caused the problem.
Can you solder 5R1 and see if it works with a long cable?
The traces don't matter, they are still relatively short.

SingularitySurfer, 2022-02-04:
I neither have resistors that small in physical size, nor any resistor < 10 ohms here..

SingularitySurfer, 2022-02-04:
Oh and actually since Thermostat has a different MCU it could be that the drivers there support 10Mbit ethernet.

gkasprow, 2022-02-04:
Isn't the RUST stack the same?

SingularitySurfer, 2022-02-04:
No, it uses a different HAL and ethernet driver. Unf I can't find it in the m-labs code right now but [here](https://github.com/stm32-rs/stm32-eth/blob/f246fae1dd37d3d20b07e84b4baaa71826388139/examples/arp.rs#L178-L185) they use the same driver a the m-labs code uses to look for any connection in the link, incl. 10Mbit. Not sure if it would work with 10Mbit after that tho.

gkasprow, 2022-02-04:
OK, that's why nobody noticed the difference

SingularitySurfer, 2022-02-04:
@jordens We don't have a new Thermostat here right?

jordens, 2022-02-04:
Not newer than what you have been playing with.

SingularitySurfer, 2022-02-09:
Some more remarks on the ESD array:
- Between Stabilizer and Thermostat-EEM I have noticed that the schematic symbol, BOM part and footprint name are exactly the same.
- The actual physical footprint seems to be slightly different with a bigger clearance between solder mask and pad on Thermostat.
- The diode array place on the actual board is not [the one in the BOM](https://octopart.com/datasheet/drtr5v0u4s-7-diodes+inc.-30954912). The marking is TG5, whereas it should be TG1 according to the BOM part. Other ESD arrays on Thermostat have the same TG5 marking.  A Stabilizer v1.2 I could look at has the TG1 marking. Unf. I was not able to find the corresponding datasheet for the TG5 marking, since I cannot search for the marking and the datasheets I could find had other markings.

It is therefore still possible that the diode array makes a difference.

jordens, 2022-02-09:
https://www.mouser.com/datasheet/2/115/DRTR5V0U4SL-476981.pdf Note the completely different pinout.

jordens, 2022-02-09:
@SingularitySurfer If this pans out, take home message for you is [check things](https://github.com/sinara-hw/Thermostat_EEM/issues/51#issuecomment-1029065804) first.

gkasprow, 2022-02-09:
There should be mounted DRTR5V0U4S-7 which has the correct layout. Essential is that pin 5 must have all cathodes connected to it.

jordens, 2022-02-09:
@gkasprow According to the marking it would be DRTR5V0U4S**L** with the different pinout. Maybe a chance to visit manufacturing and straighten them out ;)

gkasprow, 2022-02-09:
I wrote them an email. Hope they didn't assemble it in other modules.

jordens, 2022-02-09:
Anyway, no harm done. Then also no indication of ESD damage, just "undesired diodes". Good that we figured it out. Thanks all!

gkasprow, 2022-02-09:
OK. Production people assembled DRTR5V0U4SL-7 because one of the engineers told them that it's the same part.

jordens, 2022-02-09:
All the way to the name of the engineer! ;)

gkasprow, 2022-02-09:
The other TVS are also bad: D3, D4, D27, D35, D36

jordens, 2022-02-09:
Maybe also on other Thermostat and Stabilizer builds.

SingularitySurfer, 2022-02-16:
Hi @gkasprow, we have noticed that diode arrays D21 (USB) and D26 (JTAG) are different arrays with the marking "TV8" and obviously seem to work as intended in case of the JTAG. In the BOM they are the same part as the affected diodes. How come these two are different?

jordens, 2022-02-16:
Ah. USB may be 5V, too close to the Zener voltage of the TVS.
Maybe JTAG can/could do higher voltage as well. Hence those should be different parts than the others?

filipswit, 2022-02-16:
To clarify, this are mounted diodes:
D3, D4, D27, D35, D36 - DRTR5V0U4SL-7
D21, D26 - D5V0F4U6S-7

jordens, 2022-03-31:
Production issue, not a design issue. Nothing to be done.

Closed 2022-03-31.

Thread 52 (2022-02-16):

Future Thermostat-EEM design whishlist

SingularitySurfer, 2022-02-16:
This a list of design changes that we could consider in the future. To be discussed. Some items might not make sense in practice or due to other constraints.

- If a laser module is rack-mounted together with Thermostat-EEM, it would be nice to have a way of internally connecting the laser module with Thermostat. Currently the board only features front-facing connectors. Probably a connection with ribbon-cable/EEM-connector would make sense here? Also the top side component density is relatively high already.

jordens, 2022-02-16:
Best to do one issue per item. That focuses the discussion.

SingularitySurfer, 2022-02-16:
Ok, I'll rename the issue etc.

Thread 54 (2022-02-21):

Testpoints on one TEC/PWM channel soldered

nkrackow, 2022-02-21:
Small nit: The testpoints on one of the DAC/PWM output channels have solder bumps on them which is likely unintentional makes probing a bit more difficult.
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

jordens, 2022-03-31:
#50 (second point) already tracks this I think

Closed 2022-03-31.

Thread 55 (2022-02-21):

TEC Driver REF pin loading and capacitance

nkrackow, 2022-02-21:
The TEC Driver IC has a Reference pin that outputs the internal reference voltage. This pin should have a 1uF capacitor according to the datasheet, Thermostat curretly has a 10nF.
The pin can sink 1mA but only source 10uA. With the current loading the pin is pulled from nominal 1.5V to ~1.05V.
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

jordens, 2022-02-22:
This was a bug from https://github.com/sinara-hw/Thermostat_EEM/issues/46
I meant adding an 10k R 10n C filter to VREF, after the 1u C and not replacing the 1u with a 10n C and adding an R 10k. That doesn't work.

jordens, 2022-02-22:
Still, there seems to be something loading it. @SingularitySurfer sure you measured the 1.05V on the pin 4 side or R224?
In any case the voltage divider at IC14 is broken due to the non-zero impedance of R224.

SingularitySurfer, 2022-02-22:
> Still, there seems to be something loading it. @SingularitySurfer sure you measured the 1.05V on the pin 4 side or R224? In any case the voltage divider at IC14 is broken due to the non-zero impedance of R224.

Actually I measured on the wrong side of the resistor, sorry! The highlighted net on the pin has 1.5V. Behind R224 there is 1.05V left.
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

jordens, 2022-02-22:
Ok. Then it's just the divider. And the RC. Should fix both.

gkasprow, 2023-03-06:
R224=0R, C168=1uF

jordens, 2023-03-06:
@gkasprow I think that's too much load. VREF can do +10µA to -1mA. We are loading it with 25k from 4.3V worst case (see IC14).

gkasprow, 2023-03-06:
Right. So let's add another opamp to buffer it. It can be one for all four channels

gkasprow, 2023-03-06:
Or, let's replace IC14 with LM358

gkasprow, 2023-03-06:
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

jordens, 2023-03-07:
The buffer should also drive the other vref users, e.g. to the CPU.

gkasprow, 2023-03-07:
Fixed in v1.1rc2

Closed 2023-03-08.

Thread 56 (2022-02-21):

#SHDN and FREQ signals need voltage level translator

maciejprzybysz, 2022-02-21:
Same issue as in Thermostat standalone version, details described here:
[Thermostat Issue #110](https://github.com/sinara-hw/Thermostat/issues/110)

SingularitySurfer, 2022-02-22:
Thermostat-EEM has the 10k pulldown, 2k to MCU resistors on the #SHDN pin, leading to 2.7V at the pin.

> The same issue applies to all previous versions, but despite the difference in voltages, it has worked fine so far. Since release 2.2 additional 10k pulldown resistor R94 has been added to project (https://github.com/sinara-hw/Thermostat/issues/94 ). This pulldown in combination with a 2k series resistor (R31 & R85) on the #SHDN line made a voltage divider and a high level voltage dropped below 3V. As a result, MAX1968 stopped turning on.

Removing the 10k pulldown makes the driver go out of shut-down and work.
@gkasprow

gkasprow, 2022-02-22:
right, but I'd add 100k pulldown to make sure the driver won't turn on when the CPU is not initialized.

gkasprow, 2022-02-22:
I would even replace R120 with a diode and add a pullup.
That would work both as a voltage shifter and wired-and gate.
To make sure the driver won't start when MCU is not initialized I'd add pulldowns at the STM PWM outputs
@maciejprzybysz

SingularitySurfer, 2022-02-22:
Ok, thanks.

SingularitySurfer, 2022-02-22:
Actually for developing now I'd only switch the pulldowns on #SHDN to 100k. I'll do more modifications as necessary.

jordens, 2022-02-22:
Yes. I meant for design changes.

SingularitySurfer, 2022-02-23:
Some more observations:
- No pulldown resistors on #SHDN leads to the following behavior:
    - If the CPU stops (I don't know what this means exactly, I simply stop execution by terminating the probe-rs process) the output current slowly creeps up to the maximum 3A.
    - The same happens when the board is powercycled with the CPU in reset. (There must be some glitch coming from the CPU that goes above the threshold voltage)
    - The PWM limit pins and the #SHDN pin creep to about 1.5V. (The PWM pins currently also have no pulldowns)
    - The DAC output goes to 0V which means maximum negative current for the TEC driver.
- A 300K pulldown leads to a high level of 3.30V on the #SHDN pin, turning on the TEC at room temp. Stopping the CPU or powercycling wit CPU in reset leads to 0V and the TEC output is turned off.

gkasprow, 2023-03-06:
added level shifter and pulldown. This should solve the issue.
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

Closed 2024-10-08.

Thread 57 (2022-08-03):

CPU debug header very close to the side of the board

nkrackow, 2022-08-03:
The CPU debug header of Thermostat-EEM collides with the rails when inserting it into some standard, Eurocard sized enclosures.

However, it doesn't collide with the rails of the standard 19" chassis we use for Sinara systems.

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

gkasprow, 2023-03-06:
The original distance was 3.5mm from the board edge to the pin centre. Now is 4.25mm

Closed 2024-10-08.

Thread 58 (2022-08-26):

Red leds

nkrackow, 2022-08-26:
It would be nice to have one of the two sets of four LEDs on the Thermostat front side red such that they can indicate if a channel is within limits. Currently all are green.

nkrackow, 2023-03-13:
Ok, thanks.

Closed 2023-03-13.

Thread 59 (2022-11-18):

header board for thermocouples

jordens, 2022-11-18:
Thermocouples are needed where dissipation or environment prevent the use of NTCs, RTDs, and diodes

* use the special connectors, which are type-dependent
* common reference junction closely coupled to ref junction thermistor on one of the channels
* excellent frontend amplifier (LTC1052?)
* design for very small temperature gradients across relevant frontend area
* careful design of the path between junctions and amplifier with an eye on undesired thermocouple voltages
* https://www.analog.com/media/en/technical-documentation/application-notes/an28f.pdf etc. and Keithley 2182A for ideas

gkasprow, 2022-11-18:
Maybe just add [Maxim integrated AFEs](https://www.maximintegrated.com/en/products/sensors/MAX31856.html) with I2C?

gkasprow, 2023-02-02:
We already have 2 front-end board options. Maybe we should make them as a separate project...

jordens, 2023-02-02:
Agreed

gkasprow, 2023-03-06:
Moving TC and Cryo breakout to separate PCB project

Thread 61 (2023-05-12):

Use ADC GPIO to change excitation

jordens, 2023-05-12:
Figure out a robust and smart way to commute the excitation and/or change the excitation voltage/current.
Maybe solid state switches on resistors.
Commuting would suppress thermocouple voltages, changing excitation would allow measuring self-heating.
Previous thoughts on this in #3

Thread 62 (2023-06-06):

Obsolete microUSB connector

filipswit, 2023-06-06:
UJ2-MIBH-4-MSMT-TR is obsolete and needs to be raplaced in next revision.

maciejprzybysz, 2023-06-22:
https://github.com/sinara-hw/Stabilizer/issues/113

filipswit, 2024-09-16:
Replaced with MOLEX 47642-1001

Thread 64 (2024-02-15):

Missing bottom soldermask openings for S1-S4 holes

filipswit, 2024-02-15:

filipswit, 2024-10-08:
Added soldermask opening on bottom

Closed 2024-10-08.

Thread 65 (2024-03-27):

Missing screwlocks in BoM.

filipswit, 2024-03-27:

Closed 2024-10-08.

Thread 66 (2024-05-07):

TH8_Breakout is doubled in production

MatBier, 2024-05-07:
TH8_Breakout PCB is produced twice, as a pair with TH8_Breakout_Cryo and second time as a part of Thermostat_EEM PCB.

filipswit, 2024-10-08:
fixed in v1.1.1

Closed 2024-10-08.

Thread 67 (2024-09-19):

Add mounting holes on break out boards

jordens, 2024-09-19:
Four standard mounting holes in convenient locations would help a lot. Even though they are meant for experimenting and proper solutions use application-specific AFEs, the standard break out boards tend to be used quite a lot.

filipswit, 2024-10-08:
Both PCBs extended by 6mm and added four 3,2mm holes:

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

Closed 2024-10-08.

Thread 68 (2024-10-01):

Add changes for flying probe testing

MatBier, 2024-10-01:
Changes:
- [x] Add 0.5mm TPs for all supply voltages on the bottom layer
- [x] Add 1mm TPs for P12V0_IN and GND nets on the edge of the board (near 12V supply connector)
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

- [x]  Move elements minimum 3mm from the bottom edge of the board
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

Closed 2024-10-08.

Thread 69 (2024-10-08):

v1.1.1 changelog

filipswit, 2024-10-08:
- Thermostat EEM is now separated into 4 separate PCBs and renamed to be less confusing, according to table below:

|  v1.1 | v1.1.1  |
|---|---|
| Thermostat 8CH  |  Thermostat EEM |
| CRYO TC Breakout  | Thermostat EEM Breakout   |
|   |Thermostat EEM Cryo   |
| Fan Board Thermostat 8CH  | Thermostat EEM Fan Board  |

- enlarged clearance between SMT and THT components
- added missing PNs in BoM
- changed screw PNs to be proper length 6mm instead of 4mm
- J4 MOLEX connector marked as mounted by default
- fixed minor overlay issues
- optimized BoM - merged capacitors with X5R and X7R dielectric
- changed fan socket to mating with header
- changed FAN PN to MF35101V1-1000U-G99

fixed:

- #68
- #67
- #66
- #65
- #64
- #63
- #62
