sinara-hw/Thermostat_EEM/(list of files, drawings)

Other design files:
Thermostat EEM/AFE.SchDoc
Thermostat EEM/CPU_STM32F4.SchDoc
Thermostat EEM/EEM_connector.SchDoc
Thermostat EEM/Panel/Panel_Thermostat_EEM.PcbDoc
Thermostat EEM/RMII_Ethernet.SchDoc
Thermostat EEM/Supply.schdoc
Thermostat EEM/TEC_driver.SchDoc
Thermostat EEM/Thermostat_EEM.PrjPCB
Thermostat EEM/Thermostat_EEM.SchDoc
Thermostat EEM/USB.SchDoc
Thermostat_EEM_Breakout/Thermostat_EEM_Breakout.PCBDOC
Thermostat_EEM_Breakout/Thermostat_EEM_Breakout.PrjPCB
Thermostat_EEM_Breakout/Thermostat_EEM_Breakout.SchDoc
Thermostat_EEM_Cryo/Thermostat_EEM_Cryo.PCBDOC
Thermostat_EEM_Cryo/Thermostat_EEM_Cryo.PrjPCB
Thermostat_EEM_Cryo/Thermostat_EEM_Cryo.SchDoc
Thermostat_EEM_Fan_board/Thermostat_EEM_Fan_board.PCBDOC
Thermostat_EEM_Fan_board/Thermostat_EEM_Fan_board.PrjPCB
Thermostat_EEM_Fan_board/Thermostat_EEM_Fan_board.SchDoc
