sinara-hw/Thermostat_EEM/(commit log)

2020-10-21 initial schematics
    [TH8_AFE.SchDoc, TH8_CPU_STM32F4.SchDoc, TH8_EEM_connector.SchDoc, TH8_LEDs.SchDoc, TH8_RMII_Ethernet.SchDoc, TH8_Supply.schdoc, TH8_TEC_driver.SchDoc, TH8_USB.SchDoc]
2020-10-28 initial components placement
    [TH8_AFE.SchDoc, TH8_Breakout.SchDoc, TH8_CPU_STM32F4.SchDoc, TH8_EEM_connector.SchDoc, TH8_LEDs.SchDoc, TH8_RMII_Ethernet.SchDoc, TH8_Supply.schdoc, TH8_TEC_driver.SchDoc]
2021-01-19 v1.0rc4; added fan board
    [Fan_board_Thermostat_8CH.PCBDOC, Fan_board_Thermostat_8CH.PrjPCB, Fan_board_Thermostat_8CH.SchDoc, TH8_AFE.SchDoc, TH8_Breakout.SchDoc, TH8_CPU_STM32F4.SchDoc, TH8_EEM_connector.SchDoc, TH8_RMII_Ethernet.SchDoc]
2021-03-14 replaced STM32F4 with STM32H7
    [TH8_Breakout.SchDoc, TH8_Breakout_cryo.SchDoc, TH8_CPU_STM32F4.SchDoc, TH8_RMII_Ethernet.SchDoc, Thermostat_8CH.PrjPCB]
2021-11-24 v1.0rc6; modified RC filters, added temporary power section.
    [TH8_AFE.SchDoc, TH8_Breakout_cryo.SchDoc, TH8_CPU_STM32F4.SchDoc, TH8_RMII_Ethernet.SchDoc, TH8_Supply.schdoc, TH8_TEC_driver.SchDoc, TH8_USB.SchDoc, Thermostat_8CH.PrjPCB]
2021-11-25 v1.0rc7; added 3rd DC/DC
    [TH8_Supply.schdoc, Thermostat_8CH.PrjPCB]
2023-03-06 fixed vref loading
    [TH8_TEC_driver.SchDoc, Thermostat_8CH.PrjPCB]
2023-06-27 added panel design
    [Panel_Thermostat_EEM.PcbDoc, Thermostat_8CH.PrjPCB]
2024-10-08 v1.1.1 rc1
    [AFE.SchDoc, CPU_STM32F4.SchDoc, EEM_connector.SchDoc, Fan_board_Thermostat_8CH.PCBDOC, Fan_board_Thermostat_8CH.PrjPCB, Fan_board_Thermostat_8CH.SchDoc, Panel_Thermostat_EEM.PcbDoc, RMII_Ethernet.SchDoc]
2024-10-21 v1.1.1 updated license to CERN-OHL v2
    [AFE.SchDoc, CPU_STM32F4.SchDoc, EEM_connector.SchDoc, RMII_Ethernet.SchDoc, Supply.schdoc, TEC_driver.SchDoc, Thermostat_EEM.PrjPCB, Thermostat_EEM.SchDoc]
